kemfic/dart-hat/todo.md

todo
--- 
 - find connectors
	- xt60
	- diffi2c
	- can

 - double check IC pinouts are correct
	- PFETS
	- DMMT5401
	- pi header
	- connectors
		- net wiring

 - inductors
	- double check the footprint matches
	- within rating

 - ensure CAN, diffi2c input voltages are within rating

 - find clock specs

later
--- 
 - heatsinks?
 - mounting?
