kemfic/dart-hat/outputs/dart-hat.pdf

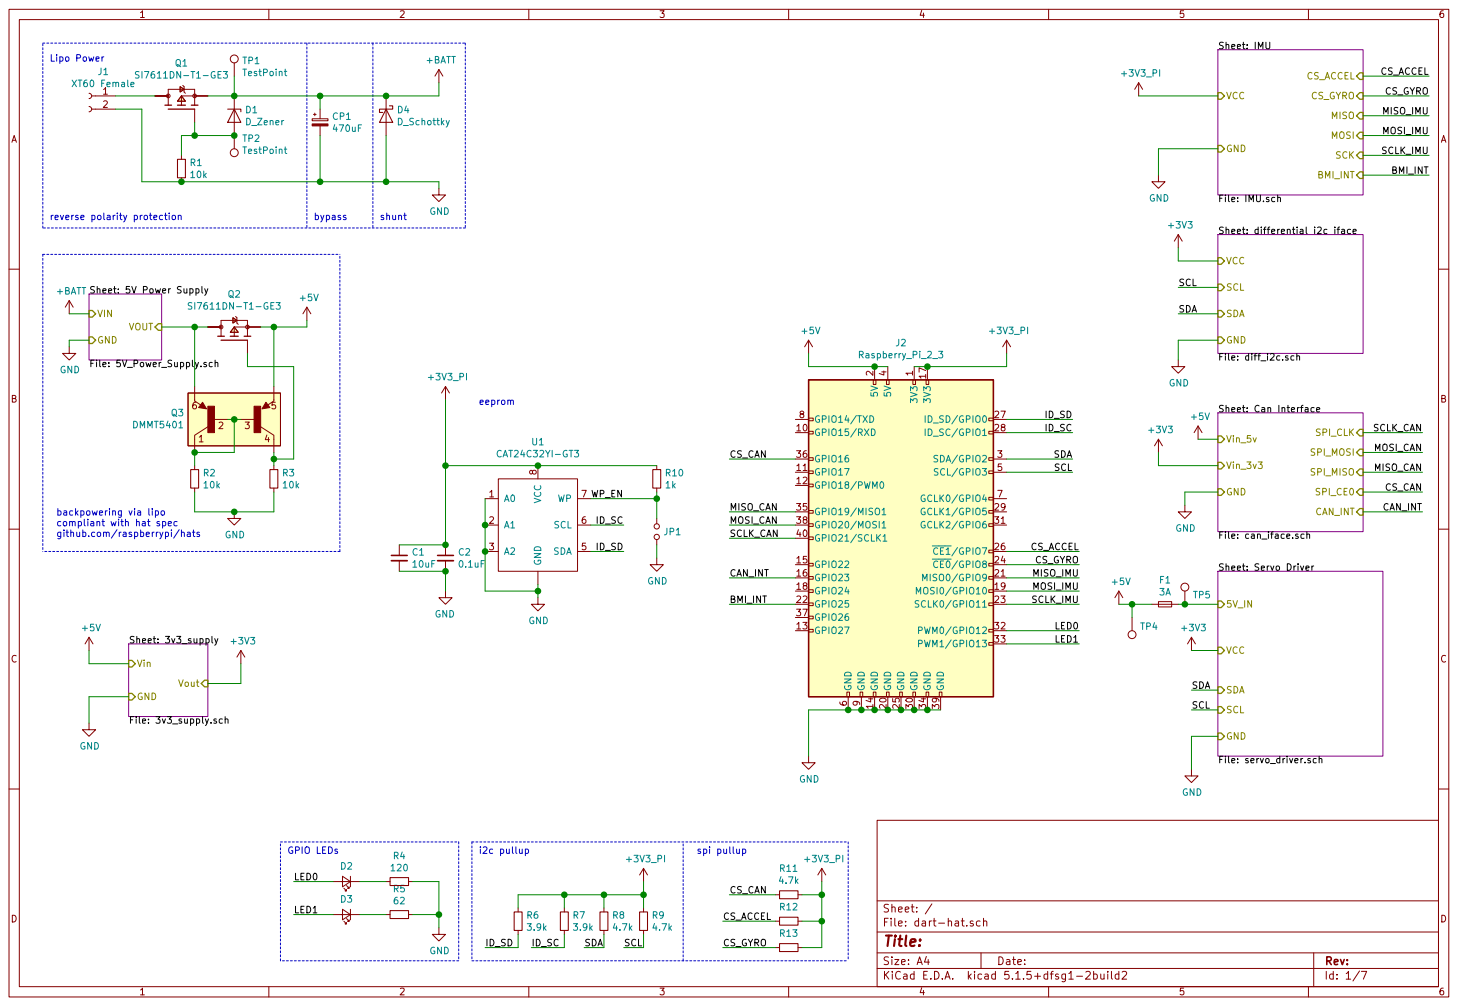
[picture p1: page 1]

Sheet: IMU
+3V3_PI GND
CAN_INT Vin_3v3 Vin_5v Sheet: differential i2c iface File: diff_i2c.sch GND

SCL SCL GPIO LEDs

Sheet: Servo Driver File: servo_driver.sch SDA

backpowering via lipo
compliant with hat spec
github.com/raspberrypi/hats

Id: 1/7 Title: File: dart-hat.sch Sheet: /

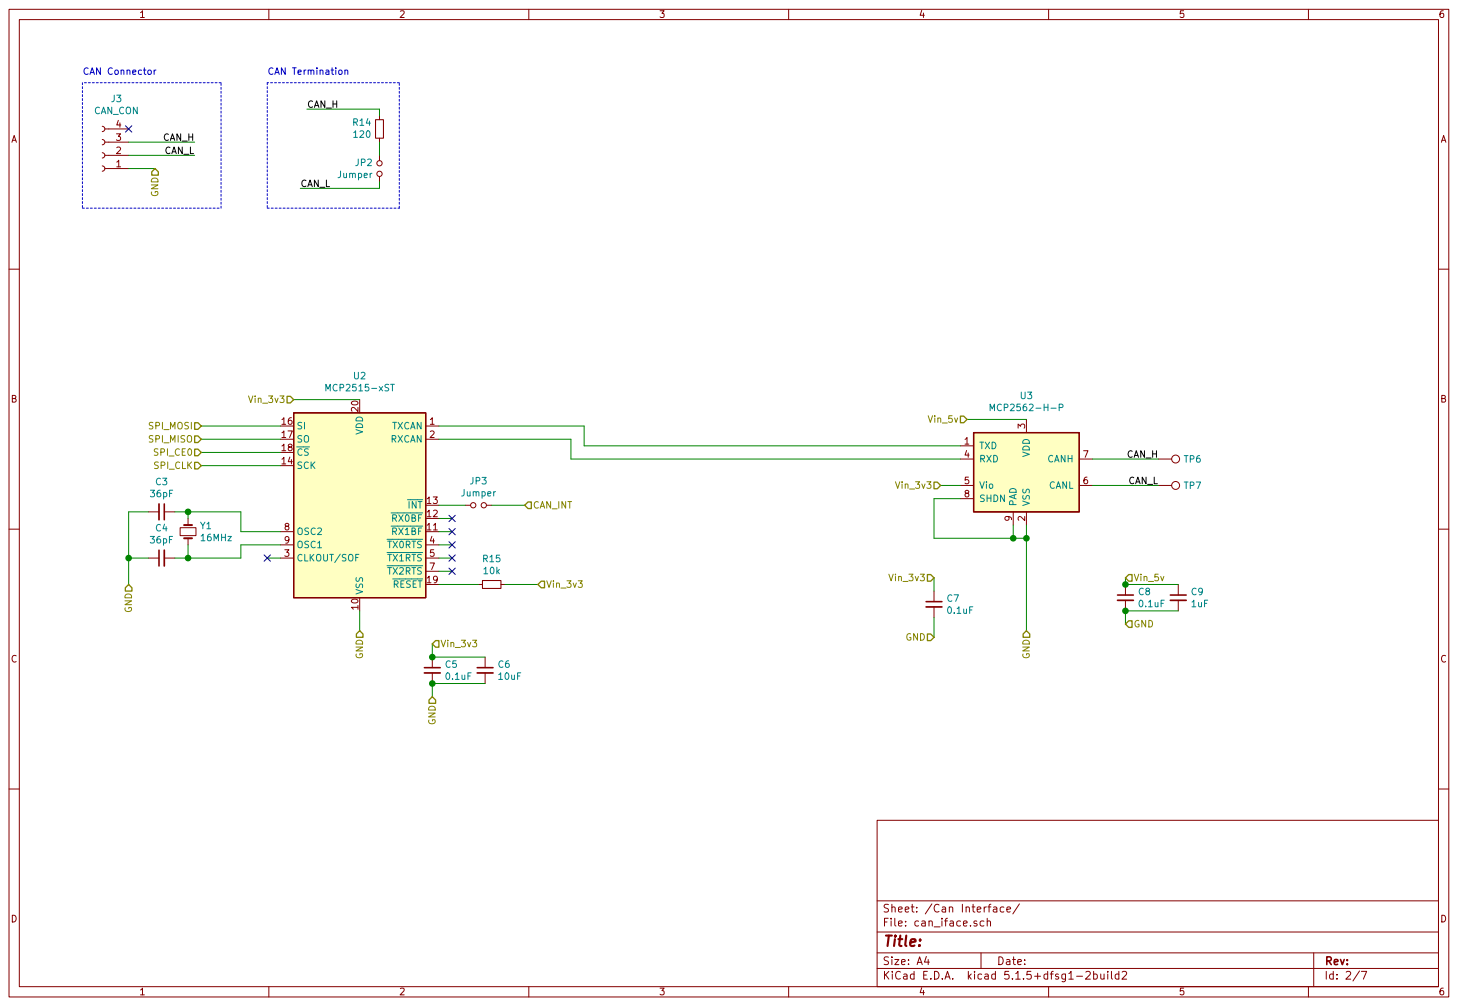
[picture p2: page 2]

3 RXD 4 Vio 5 CANL 6 CANH 7 SHDN 8 PAD

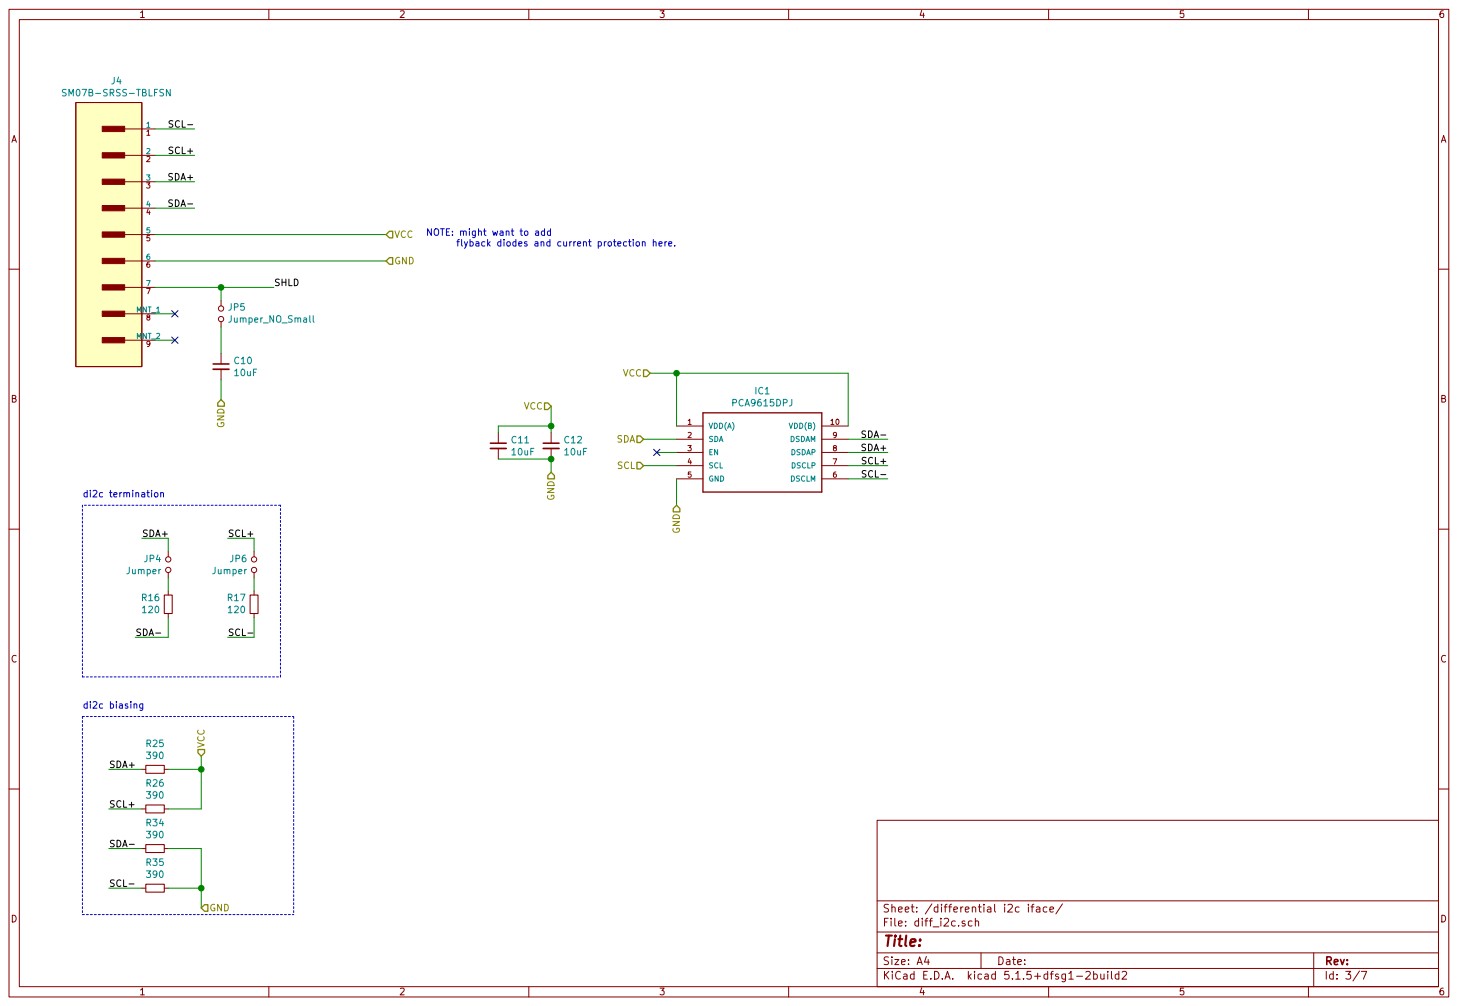
[picture p3: page 3]

NOTE: might want to add
VCC

flyback diodes and current protection here.

File: diff_i2c.sch Sheet: /differential i2c iface/
Id: 3/7 Title:

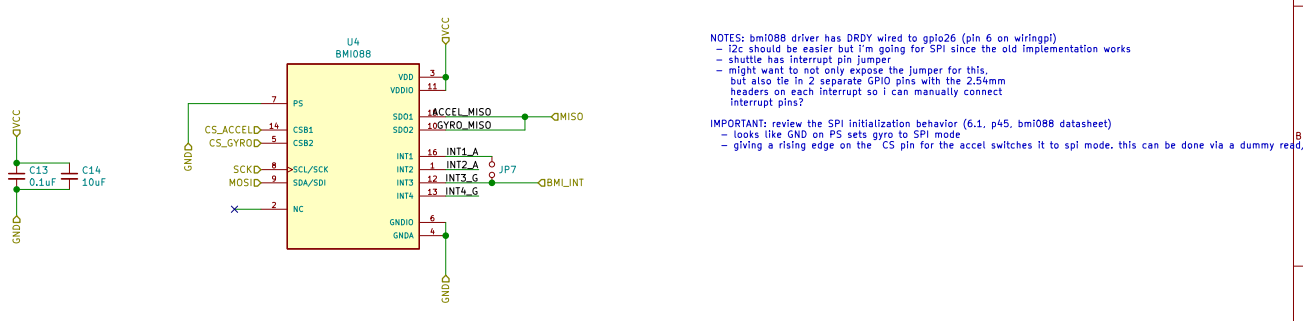
[picture p4: page 4]

NOTES: bmi088 driver has DRDY wired to gpio26 (pin 6 on wiringpi)
- i2c should be easier but i'm going for SPI since the old implementation works
- shuttle has interrupt pin jumper
- might want to not only expose the jumper for this,
but also tie in 2 separate GPIO pins with the 2.54mm
headers on each interrupt so i can manually connect
interrupt pins?

IMPORTANT: review the SPI initialization behavior (6.1, p45, bmi088 datasheet)
- looks like GND on PS sets gyro to SPI mode
- giving a rising edge on the CS pin for the accel switches it to spi mode. this can be done via a dummy read/write operation

Id: 4/7 Title: File: IMU.sch Sheet: /IMU/

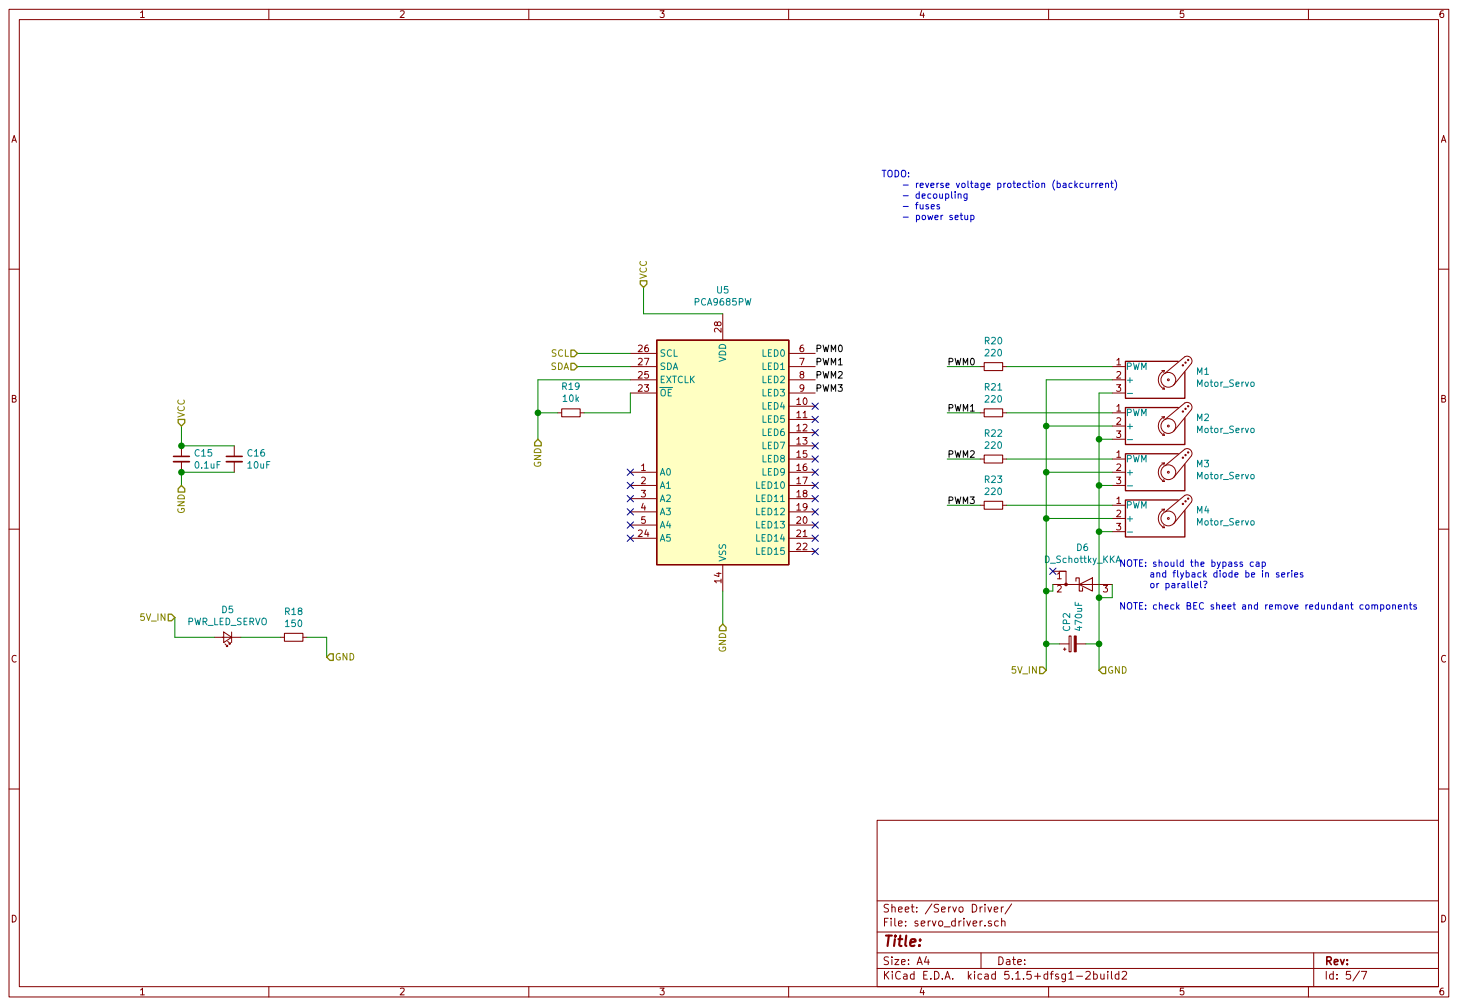
[picture p5: page 5]

and flyback diode be in series
or parallel?

NOTE: check BEC sheet and remove redundant components

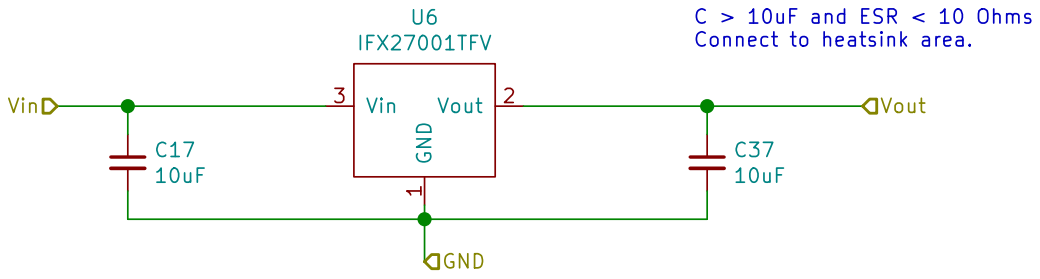
[picture p6: page 6]

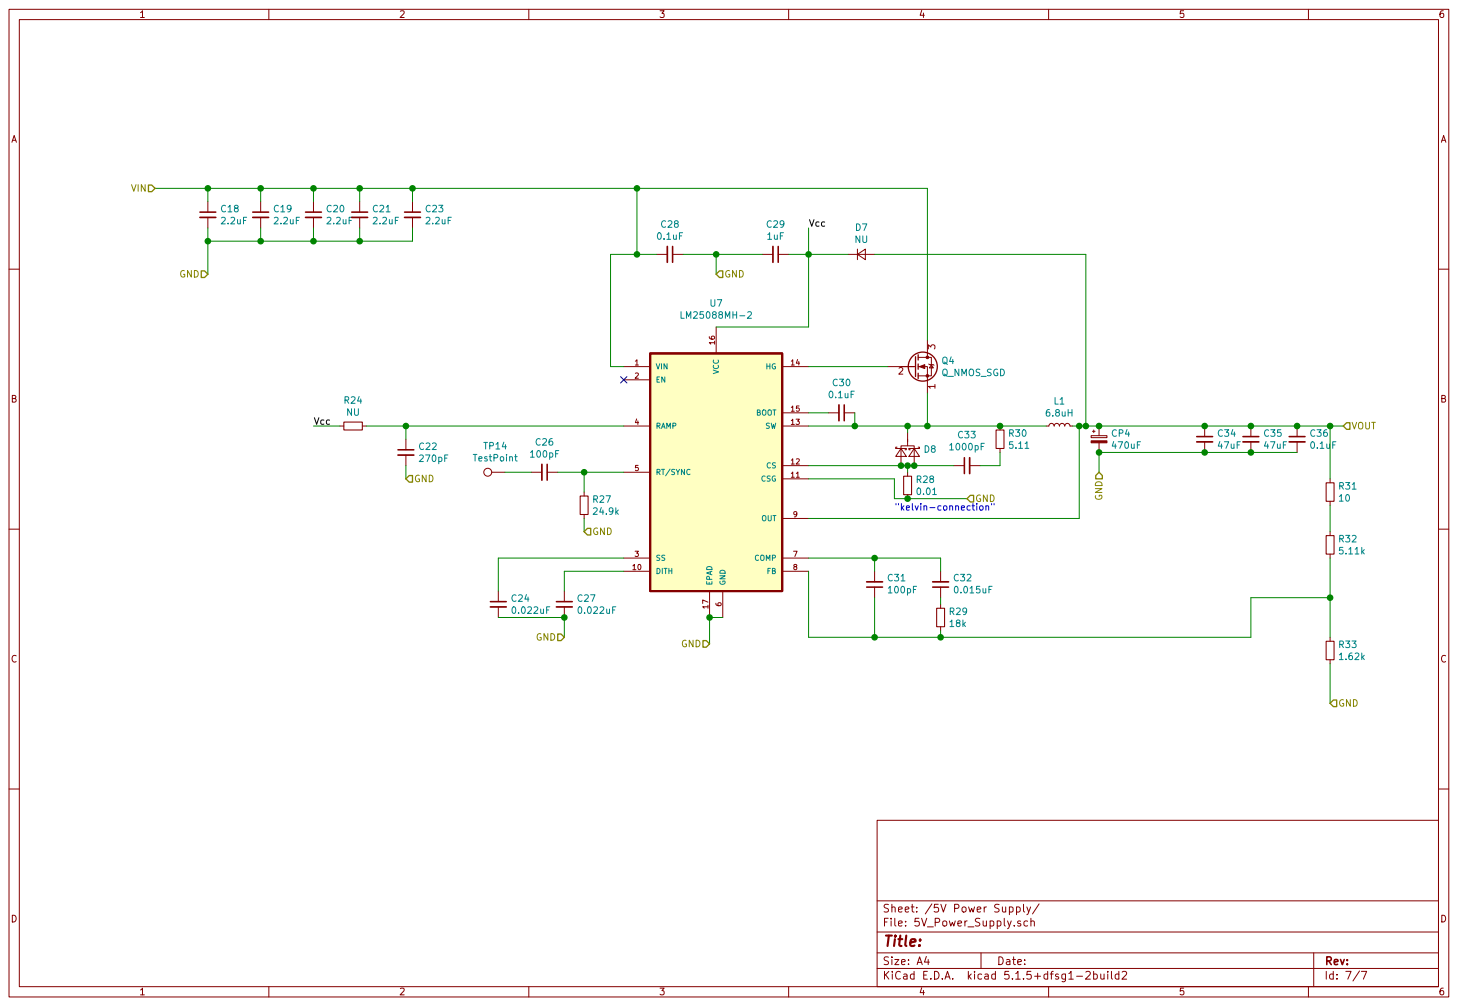
[picture p7: page 7]
