kemfic/dart-hat/meta/dart-hat-B_SilkS.pdf

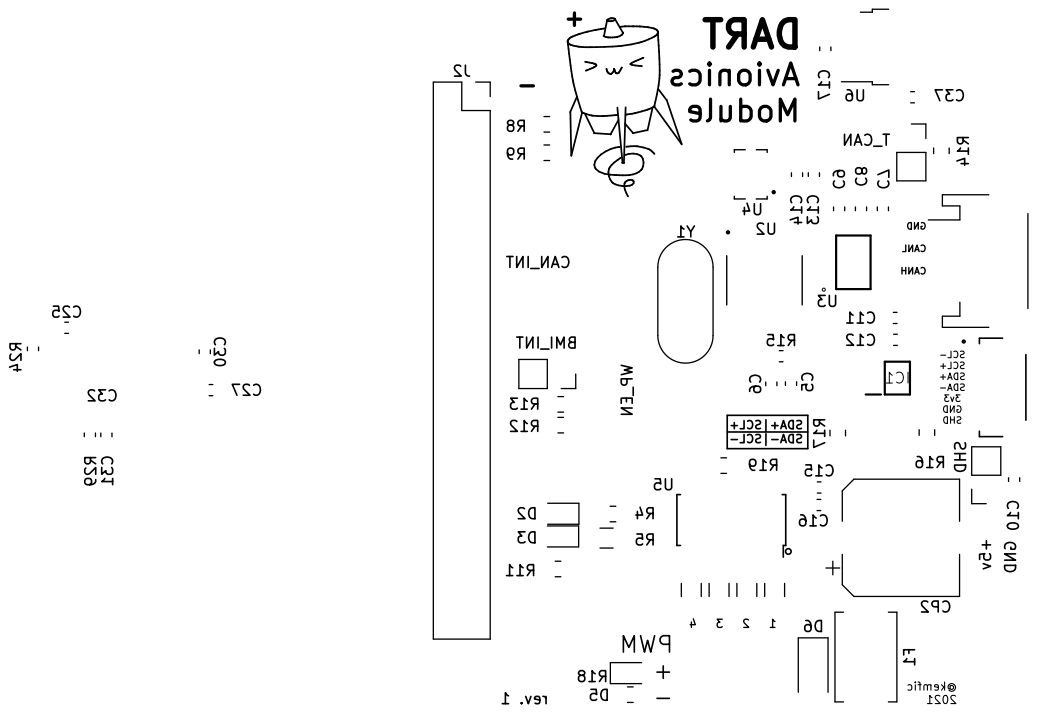
[picture p8: page 1]

SHD PWM +- SDA+|SCL+ SDA-|SCL- - + +5v GND

SCL- SCL+ SDA+ SDA- 3v3 GND
