kemfic/dart-hat/meta/dart-hat-B_Cu.pdf

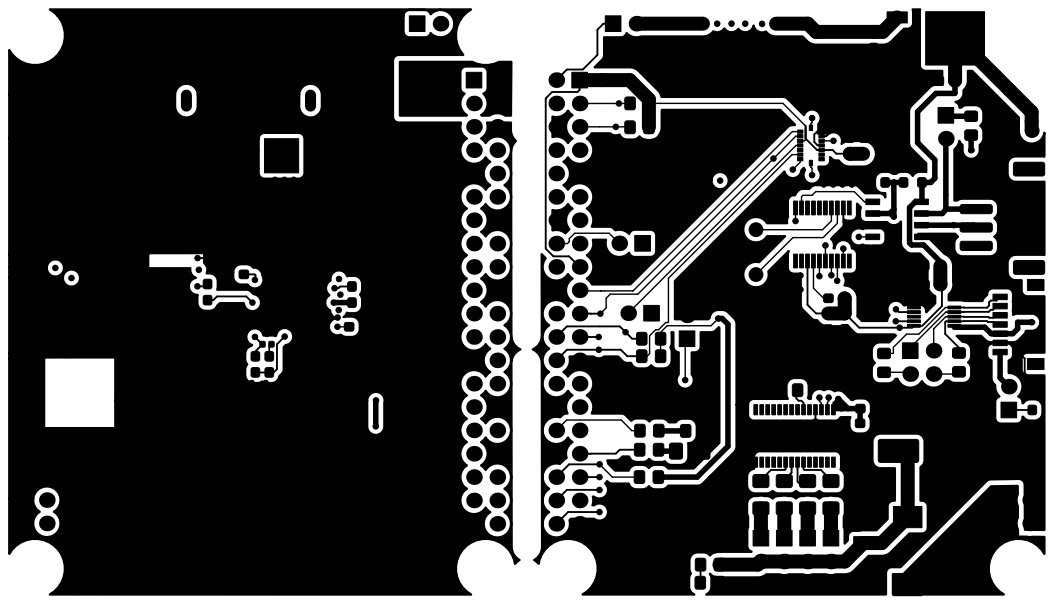
[picture p9: page 1]
