kemfic/dart-hat/meta/dart-hat-F_Cu.pdf

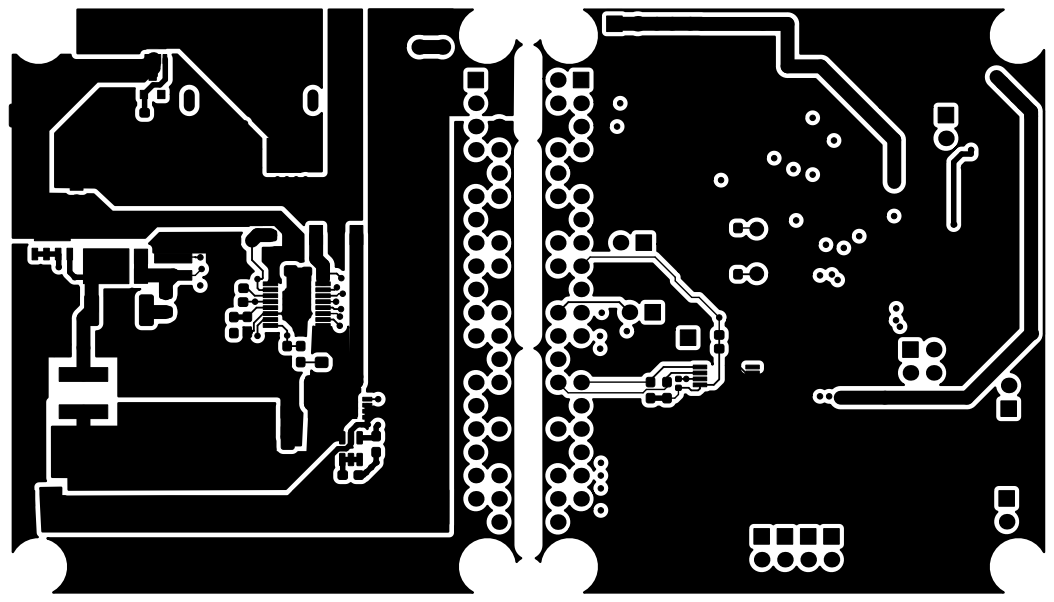
[picture p10: page 1]
