kemfic/dart-hat/meta/dart-hat-F_SilkS.pdf

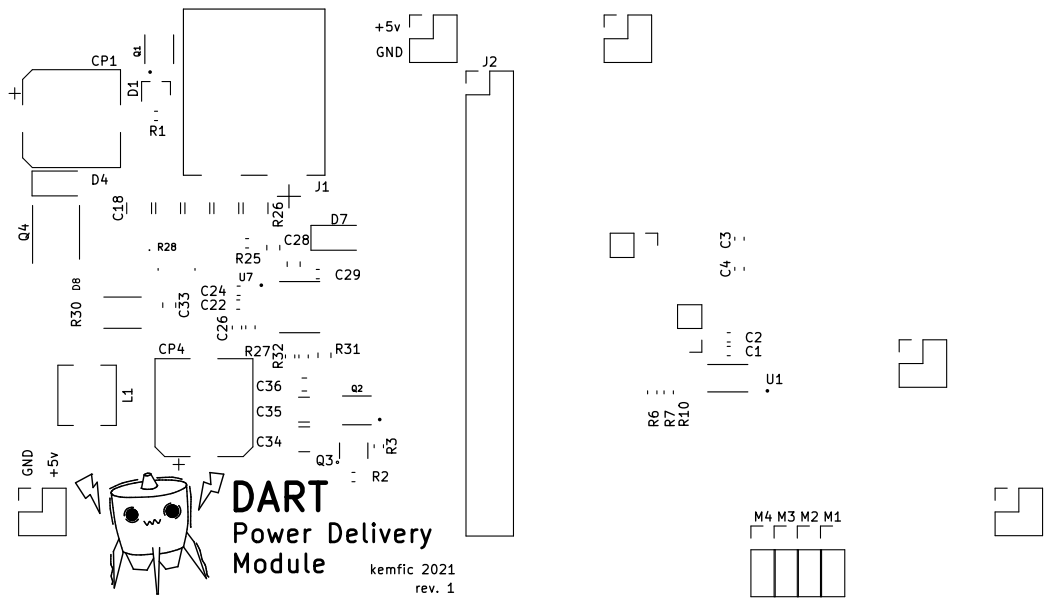
[picture p11: page 1]
