kemfic/dart-hat/meta/dart-hat-In1_Cu.pdf

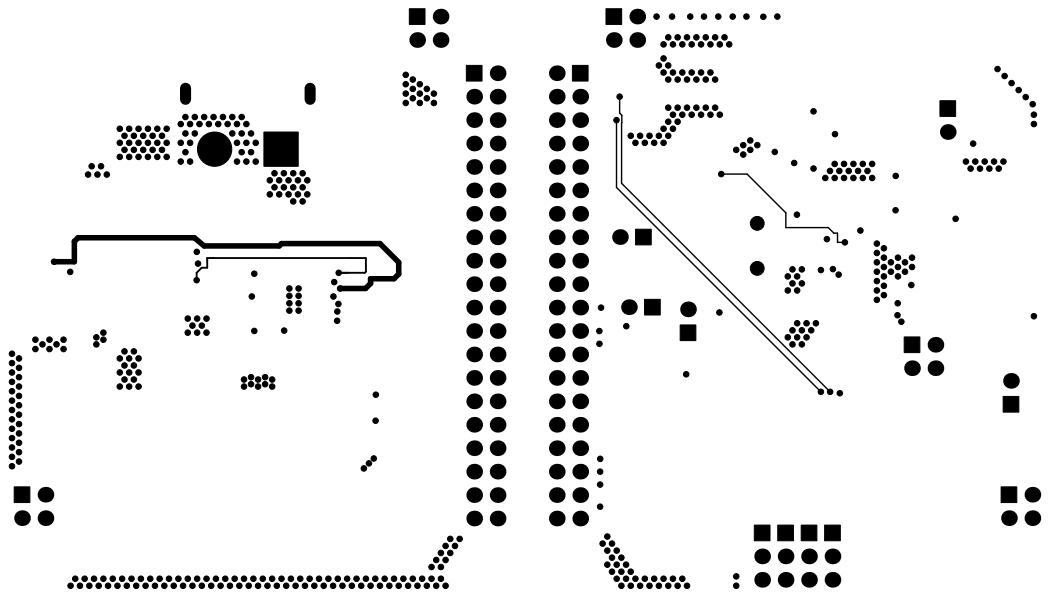
[picture p12: page 1]
