kemfic/dart-hat/meta/dart-hat-In2_Cu.pdf

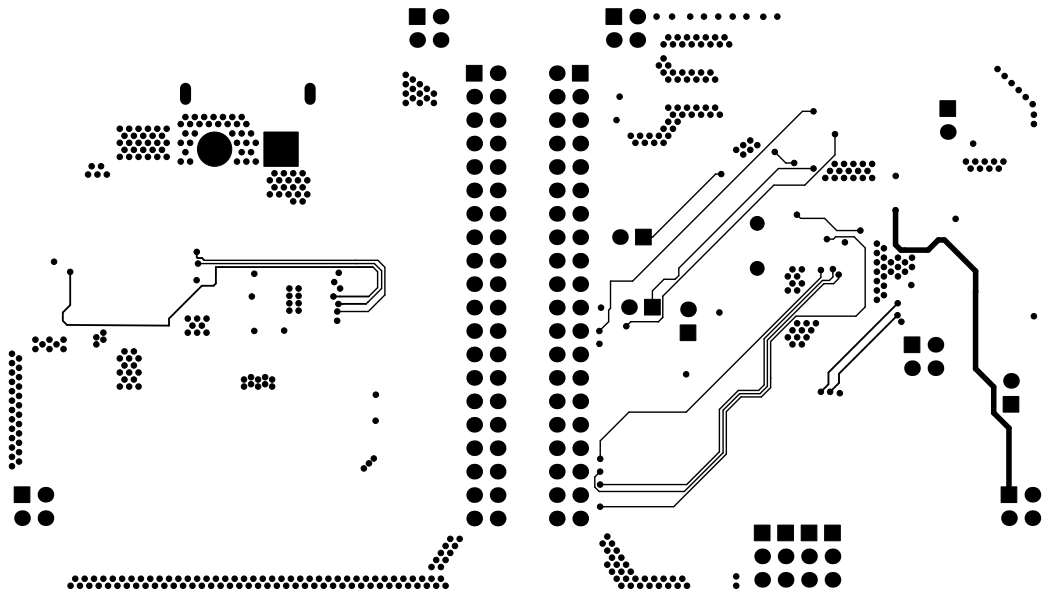
[picture p13: page 1]
