kemfic/dart-hat/docs/sparkfun-diffi2c.pdf

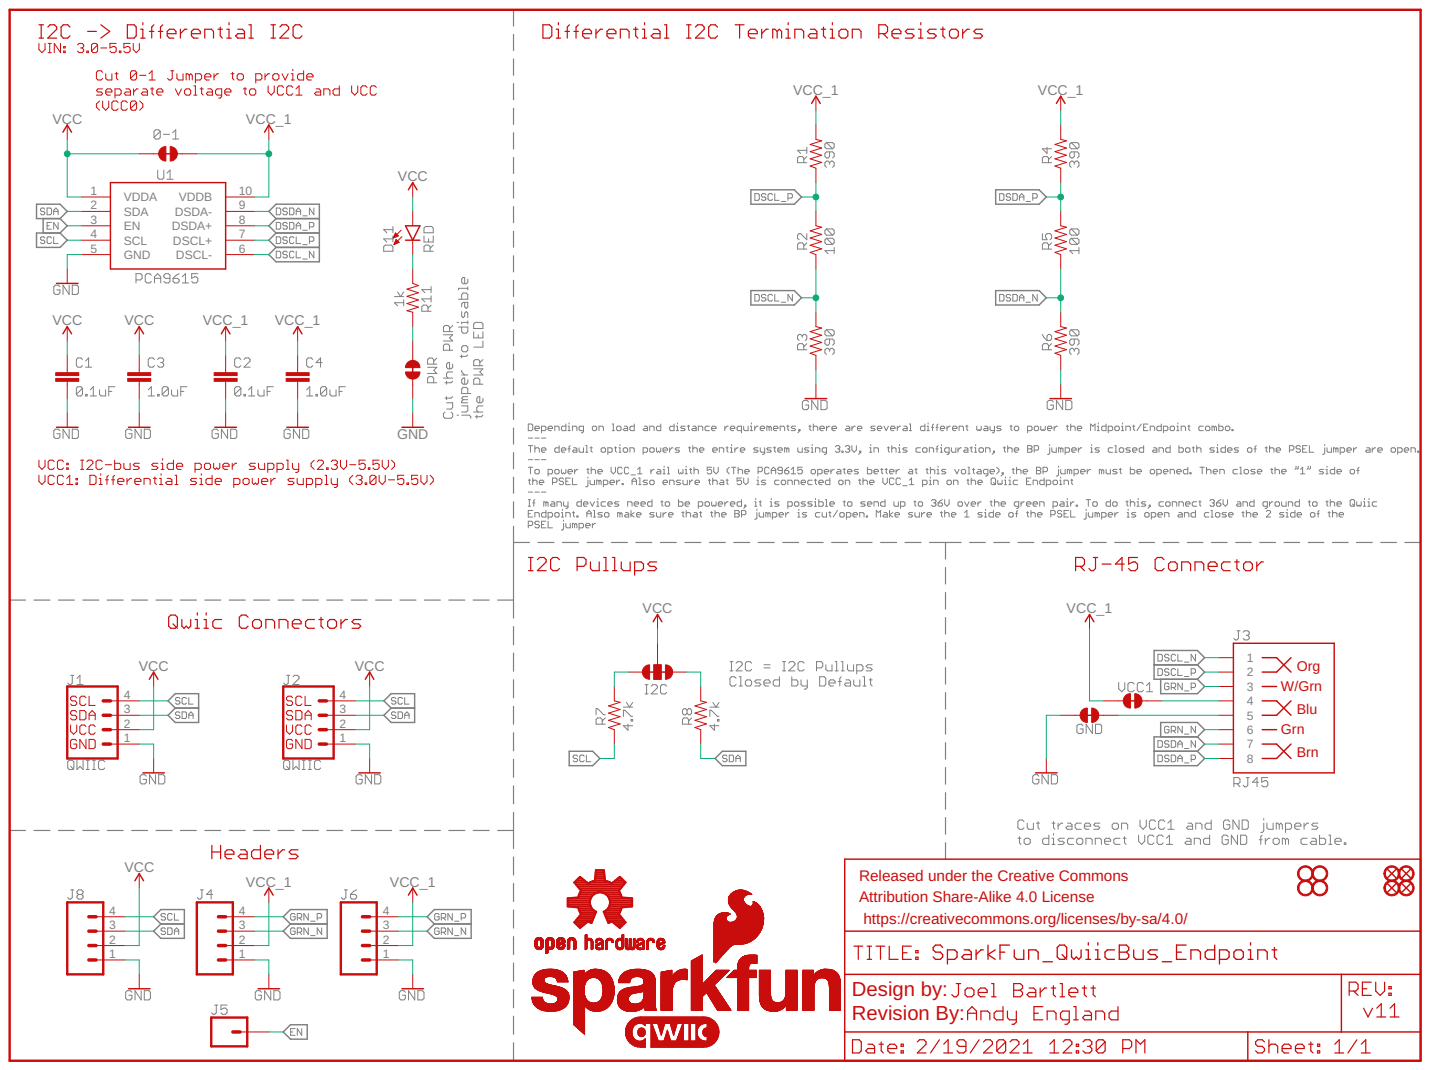
[picture p14: page 1]

https://creativecommons.org/licenses/by-sa/4.0/
