kemfic/dart-hat/docs/old-hat.pdf

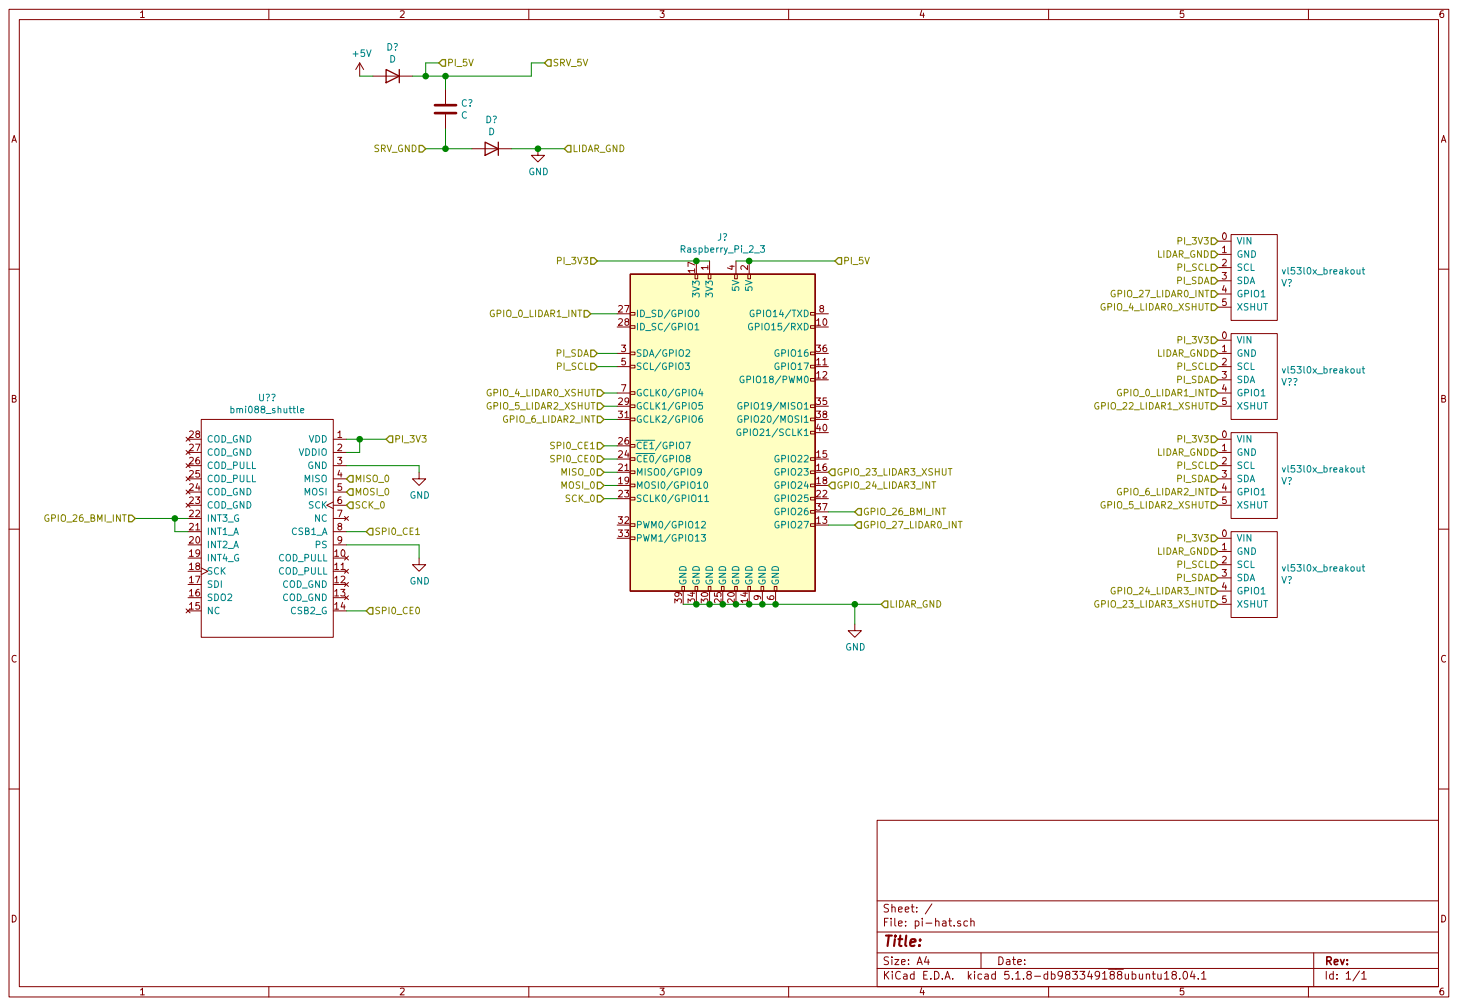
[picture p15: page 1]

File: pi-hat.sch Sheet: /
Id: 1/1 Title:
