kemfic/dart-hat/(commit log)

2021-11-26 [main] update zvd resistor values
    [dart-hat.sch]
2021-11-26 remove cap from mcp2551
    [5v_bec.sch, can_iface.sch]
2021-11-27 update reference ids, assign value to c8
    [3v3_bec.sch, 5v_bec.sch, IMU.sch, can_iface.sch, dart-hat.sch, diff_i2c.sch, servo_driver.sch]
2021-11-28 no longer a hat lol
    [3v3_bec.sch, 5v_bec.sch, IMU.sch, can_iface.sch, dart-hat.kicad_pcb, dart-hat.sch, diff_i2c.sch, servo_driver.sch]
2021-12-02 [schematic] fix 3v3 symbol pin to use 3v3_pi instead of 5V_SRV
    [dart-hat.kicad_pcb, dart-hat.sch, diff_i2c.sch, servo_driver.sch]
2021-12-04 [power supply] basic schematic for new 5V power supply, LM25088MH-2
    [5V_Power_Supply.sch, dart-hat.sch]
2021-12-07 power supply overhaul
    [3v3_bec.sch, 3v3_supply.sch, 5V_Power_Supply.sch, 5v_bec.sch, IMU.sch, can_iface.sch, dart-hat.kicad_pcb, dart-hat.sch]
2021-12-18 final final sch
    [5V_Power_Supply.sch, can_iface.sch, dart-hat.sch, servo_driver.sch]
2021-12-19 [pcb] added copper planes
    [5V_Power_Supply.sch, can_iface.sch, dart-hat.kicad_pcb, file61B07269.sch, file61BC5F5A.sch]
2021-12-21 add mousebites
    [dart-hat.kicad_pcb]
2021-12-21 added vias and graphics
    [dart-hat.kicad_pcb]
2022-01-11 [rev.2 fixes] - fix Q4 net pin assignment - removed UVLO - fix kelvin connection on R_sense - fix MCP2515 symbol + pinout - changed oscillator capacitors for 18uF load capacitance - PCA9615 biasing r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
    [5V_Power_Supply.sch, can_iface.sch, dart-hat.kicad_pcb, dart-hat.sch, diff_i2c.sch]
